yusufonaran0/Ultrasound-HS-SR04-BPA-DEL26-/images/detailed_rtl_schmetaics_vivado.png

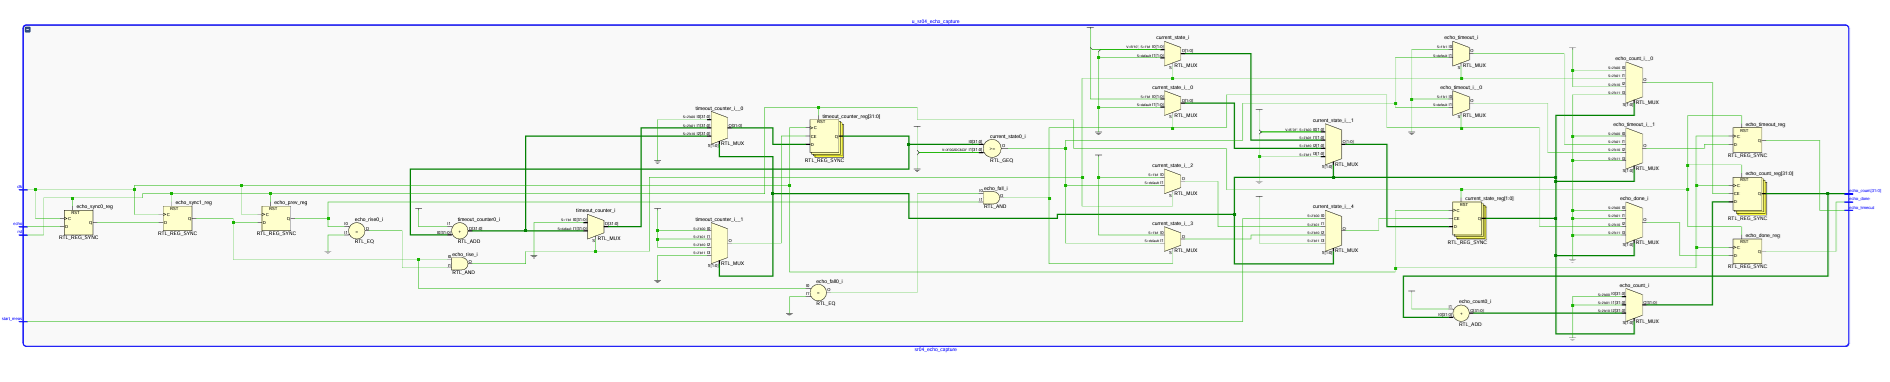
images/detailed_rtl_schmetaics_vivado.png
