yusufonaran0/Ultrasound-HS-SR04-BPA-DEL26-/images/rtl_schematics_vivado.png

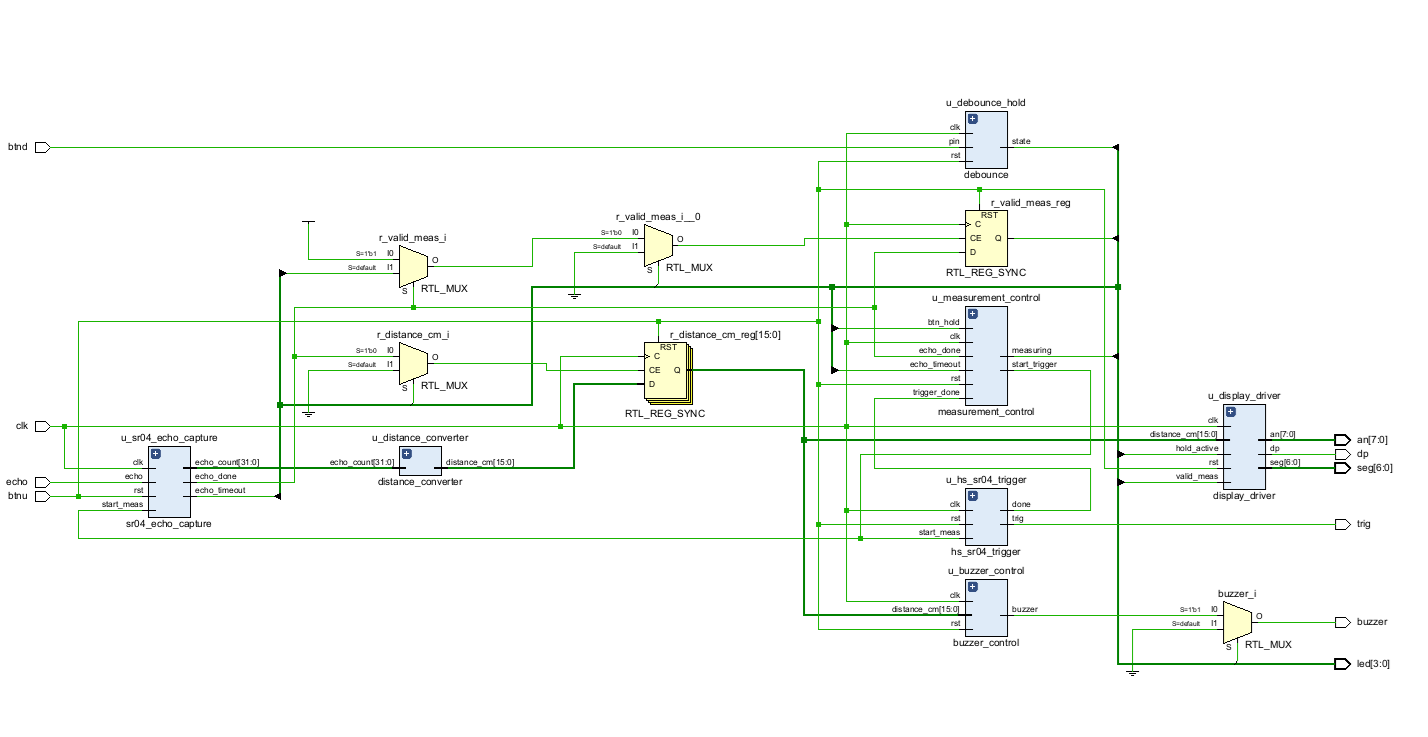
images/rtl_schematics_vivado.png
