yusufonaran0/Ultrasound-HS-SR04-BPA-DEL26-/(commit log)

2026-04-28 Create schematics
2026-04-28 Update schematics
2026-04-28 Create ultrasonic_top_tb
2026-04-28 Create ultrasonic_top_tb.v
2026-05-01 Rename ultrasonic_timing principle.jpg to ultrasonic_timing_principle.jpg
